momo505/Bachelorthesis/README.md

# Bachelorthesis
Repo für Bachelorarbeit
