momo505/Bachelorthesis/Kettenroboter/Hardware/KiCad/Bauteil-Library/Wuerth_Screw_Term3_2pin/WR-TBL_V3_pin2_691103110002.step

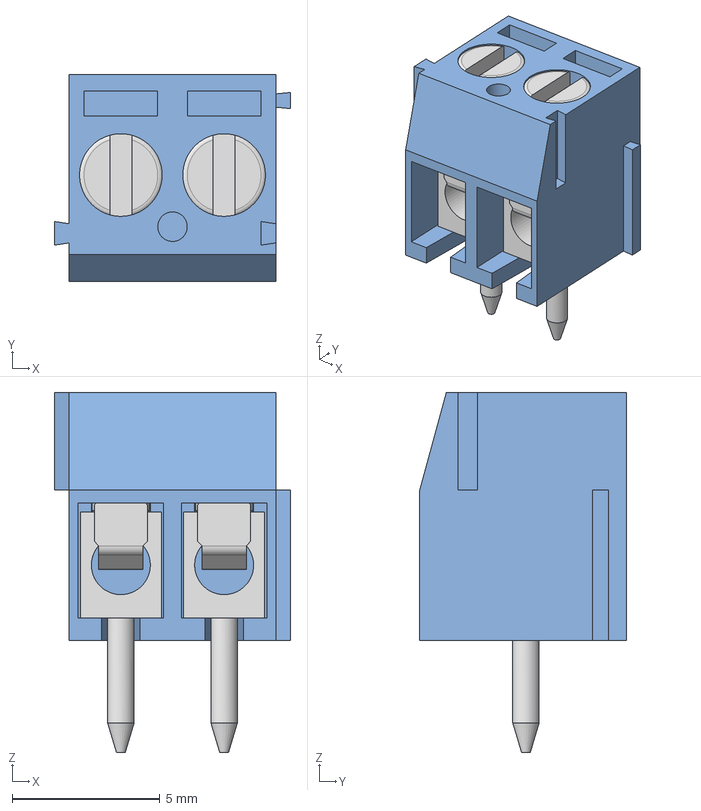
[picture p2: CAD file, 2026-04-20]
Kettenroboter/Hardware/KiCad/Bauteil-Library/Wuerth_Screw_Term3_2pin/WR-TBL_V3_pin2_691103110002.step
8.00 x 7.00 x 12.2 mm
6911031100xx_CAGE x 2
6911031100xx_PIN x 2
6911031100xx_VIS x 2
