momo505/Bachelorthesis/Kettenroboter/Software/Pico2W_TRS_Testup/deprPico2W_TRS_Testup2.txt

#include <Wire.h>
#include <FreeRTOS.h>
//#include "MySoftwareWire.h"
bool core1_separate_stack = true;
// enable FreeRTOS SMP with Tools: Operating System: FreeRTOS SMP
// compile with acli compile -j 0 -v -e -b rp2040:rp2040:rpipico2w
// (in windows compile pio asm with pioasm.exe pio_code.pio pio_code.pio.h
// find port: sudo dmesg | egrep -i --color 'ttyACM'
// arduino-cli upload I2Csketch.ino -p /dev/ttyACM0 -b rp2040:rp2040:rpipico2w
// serial: sudo screen /dev/ttyACM0 115200          (ctrl-d to detach)

// ========================= MOTOR A/B CONFIG =========================
#include "motor_config.h"

// ========================= MD03 CONFIG flipper 1 =========================
//#include "md03_config.h"

/*
volatile long encoderCount1 = 0;
volatile long encoderCount2 = 0;
volatile long encoderCount1B = 0;
volatile long encoderCount2B = 0;
*/
/*
long targetAngle = 0;
bool homed = false;
const float countsPerDegree = 24600.0 / 360.0; // 68,3333333333333
long homePosition1 = 0;
long homePosition2 = 0;
*/
#define ENCODER_COUNTS_FULL_ROT 24600.0
#define COUNTS_PER_DEGREE (ENCODER_COUNTS_FULL_ROT / 360.0)

// ========================= SOFTWARE I2C SRF02 =========================
//MySoftwareWire sw(10, 11);
byte frontSensors[] = {0x78, 0x76, 0x7E};

// ========================= FLIPPER CONTROL =========================
//#include "flipper_control.h"

// ========================= I2C HELPERS =========================
//#include "i2c_helpers.h"

// ========================= SRF02 READ =========================
//#include "srf02.h"

// ========================= MCP2515-CAN =========================

#include <Adafruit_MCP2515.h>
#include "can_db.h"
#ifdef ARDUINO_ADAFRUIT_FEATHER_RP2040
   #define ADA_CS_PIN    7
#elif defined(ARDUINO_ADAFRUIT_FEATHER_RP2040_CAN)
   #define ADA_CS_PIN    PIN_CAN_CS
#elif defined(ARDUINO_RASPBERRY_PI_PICO) || defined(ARDUINO_RASPBERRY_PI_PICO_W) // PiCowbell CAN Bus
   #define ADA_CS_PIN    20
#else
    // Anything else, defaults!
   #define ADA_CS_PIN    5
#endif
// Set CAN bus baud rate
#define CAN_BAUDRATE (250000)
Adafruit_MCP2515 mcp(ADA_CS_PIN);
//*/

//*
// ========================= Postbox / Pico-SDK Mutex =========================
#include <FreeRTOS.h>
#include "semphr.h"
#include "icc.h"
#define POSTBOXSIZE 32

SemaphoreHandle_t  pb_mutex; // = xSemaphoreCreateMutex();
volatile bool newcontent = false;
volatile uint32_t postbox[POSTBOXSIZE] = {0};
volatile long ct_pb = 0;
volatile byte motor_pb[2][7] = {0};
volatile byte flipper_pb[2][7] = {0};
volatile uint32_t flags = 0;

SemaphoreHandle_t serialmutex; 

//*

// ========================= SETUP =========================
bool success;
byte error = 10;
unsigned long c0_lastExecutedMillis, c1_lastExecutedMillis = 0;
unsigned long c0_currentMillis, c1_currentMillis = 10; //millis();
uint8_t swcase = 0;
byte motor_add[] = {MOTOR_A_ADDR, MOTOR_B_ADDR};
byte regs[] = {DIR_REG, STATUS_REG, SPEED_REG, ACCEL_REG, TEMP_REG, CURR_REG, VERSION_REG};
byte motor = 0;
bool can_available = false;
bool printvalues = false;

unsigned long c0_cycletime, c1_cycletime, ct_buf = 0;

byte motor_c0_readvalues[4][7] = {0};
byte motor_c1_readvalues[4][7] = {0};

// SINGLECORE-MODE (runs both loops sequentially on core0)
const bool singlecore = true;

bool test;

void setup() {

    // Serial Setup
    Serial.begin(1000000);
    while(!Serial){delay(10);}
    Serial.println("Serial Ready ----------------------   ");

    //Mutex für postbox
    pb_mutex = createMutex();
    serialmutex = createMutex();
    //mutexTake(serialmutex);
    if((pb_mutex != NULL) && (serialmutex != NULL)){
        Serial.println("Mutex created postbox up and working ");
    }else{
        Serial.println("!Error: Could not create Mutex!");
    }
    if(mutexTake(pb_mutex)){
        delay(1);
        mutexGive(pb_mutex);
    }
    Serial.println("Setup on core0 finished");
    Serial.print(" MCU running at "); Serial.print(rp2040.f_cpu()/1000); Serial.println(" kHz");

    //Serial.println(" Running MCP2515 Sender test!");

    ///*
    //CAN.setSPIFrequency(frequency);
    if (!mcp.begin(CAN_BAUDRATE)) {
        Serial.println("Error initializing MCP2515.");
        can_available = false;
    }else{
        Serial.println("MCP2515 chip found");
        can_available = true;
    }
    //*/

    //
    //if(Wire1.setSCL() && Wire1.setSDA()){
        //Serial.println("starting Sensor-I2C");
    //}else{
        //Serial.println("Could not start Sensor-I2C");
    //}
    //mutexGive(serialmutex);
   // rp2040.restartCore1();
   if(singlecore==true){
        //rp2040.idleOtherCore();
        setupCore1(); 
        Serial.println("Program running on Core0 only (Singlecore)");
    }else{
        Serial.println("Program running on both Cores (Dualcore)");
    }
}

void setupCore1(){ // Core1: Motor control, QEI & Control loops
    pinMode(LED_BUILTIN, OUTPUT);
    digitalWrite(LED_BUILTIN, HIGH);

    //Serial.println("Serial switched to Core1");
    
    /*
    success = Wire.setSCL(1) && Wire.setSDA(0);
    */
    Wire.setSCL(1); Wire.setSDA(0);
    //*/

    //Serial.println("starting Motor-I2C");
    Wire.begin();
    //Serial.println("Motor-I2C should be up, Resuming Serial to Core0");
    //mutexGive(serialmutex);
    digitalWrite(LED_BUILTIN, LOW);
}

void setup1(){ if(singlecore==false){setupCore1();}}

// ========================= LOOP =========================
void loop() {

    c0_currentMillis = millis();
    if (c0_currentMillis - c0_lastExecutedMillis >= 471) 
    {
    c0_lastExecutedMillis = c0_currentMillis; // save the last executed time

    test=!test;
    //if(test=true){rp2040.idleOtherCore();}else{rp2040.resumeOtherCore();}

    Serial.println("    Ping from Core0");
    if(mutexTake(pb_mutex)){
        Serial.println(" Mutex availabe for Core0, copy OP started");
        if(newcontent == true){
            newcontent = false;
            Serial.println(" new content available:");

            // Kopiert die 28 Bytes aus der Postbox zurück in das lokale 2D-Array
            memcpy(motor_c0_readvalues, (void*)&postbox[0], sizeof(motor_c0_readvalues));
            
            printvalues = true;
        }else{
            Serial.println("! no new content available :(");
            printvalues = false;
        }
        ct_buf = ct_pb;

        mutexGive(pb_mutex);

        if(printvalues==true){

        for(int i=0; i<2; i++){
            Serial.print("   -> Data from Motor "); Serial.print(i); Serial.println(": "); Serial.print(" { ");
            for(int ii=0; ii<7; ii++){
                Serial.print(" [ Value "); Serial.print(ii); Serial.print(": "); Serial.print(motor_c1_readvalues[i][ii]); Serial.print(" ] ");
            }
            Serial.println(" } ");
        }
        printvalues = false;
        
        }
    }else{
        Serial.println("<- Mutex taken ");
    }

    Serial.print(" core0 cycle time: "); Serial.println((int)c0_cycletime);
    Serial.print(" core1 cycle time: "); Serial.println((int)ct_pb);

    // CAN-Comms:
    Serial.println("CAN-MCP-Test:");
    mcp.beginPacket(0x12);
    mcp.write('h');
    mcp.write('e');
    mcp.write('l');
    mcp.write('l');
    mcp.write('o');
    mcp.endPacket();

    // Serial Input
    
    for(int i=Serial.available(); i>=0; i--){
        Serial.read();
    }

    Serial.println("loop0 finished");
    //rp2040.resumeOtherCore();
    c0_cycletime = millis() - c0_currentMillis; 
    }
    if(singlecore==true){loopCore1();}
}

void loopCore1(){ // Core1: Motor control, QEI & Control loops

    c1_currentMillis = millis();
    //if ((c1_currentMillis - c1_lastExecutedMillis >= 100)  || (singlecore==true) /* */) {
    c1_lastExecutedMillis = c1_currentMillis; // save the last executed time

    digitalWrite(LED_BUILTIN, !digitalRead(LED_BUILTIN));
    for(int j=0; j<2; j++){

    //Wire.begin();
    for(int jj=0; jj<7; jj++){
    Wire.beginTransmission(motor_add[j]);
    Wire.write(regs[jj]);
    //error = 
    Wire.endTransmission(true);
    /*Serial.print(error);
    switch (error) 
    {case 1: Serial.println("Success"); break; case 2: Serial.println("Data too long"); break; case 3: Serial.println("NACK on transmit of address"); break; case 4: Serial.println("NACK on transmit of data"); break; case 5: Serial.println("Timeout"); break;}
    */

    Wire.requestFrom(motor_add[j], 1);

    if(Wire.available()){
        motor_c1_readvalues[j][jj] = Wire.read();
    }else{
    }
    //Wire.endTransmission(true);
    }
    //Wire.end();
    }
    
    // Postbox-Exchange:
    // Mutex sperren (z. B. xSemaphoreTake / mutex_enter_blocking)
    if(mutexTake(pb_mutex)){
    // Kopiert die 28 Bytes ab dem gewünschten START_INDEX in die Postbox
    memcpy((void*)&postbox[0], motor_c1_readvalues, sizeof(motor_c1_readvalues));

    ct_pb = c1_cycletime;

    newcontent = true;

    // Mutex entsperren (z. B. xSemaphoreGive / mutex_exit)
    mutexGive(pb_mutex);
    }
    
    c1_cycletime = millis() - c1_currentMillis;
    /*
    }
    //*/
}

void loop1(){ if(singlecore==false){loopCore1();}}
