momo505/Bachelorthesis/Kettenroboter/Hardware/KiCad/Basis/Basis.kicad_pcb

## KiCad design Kettenroboter/Hardware/KiCad/Basis/Basis.kicad_pcb (2026-04-20)

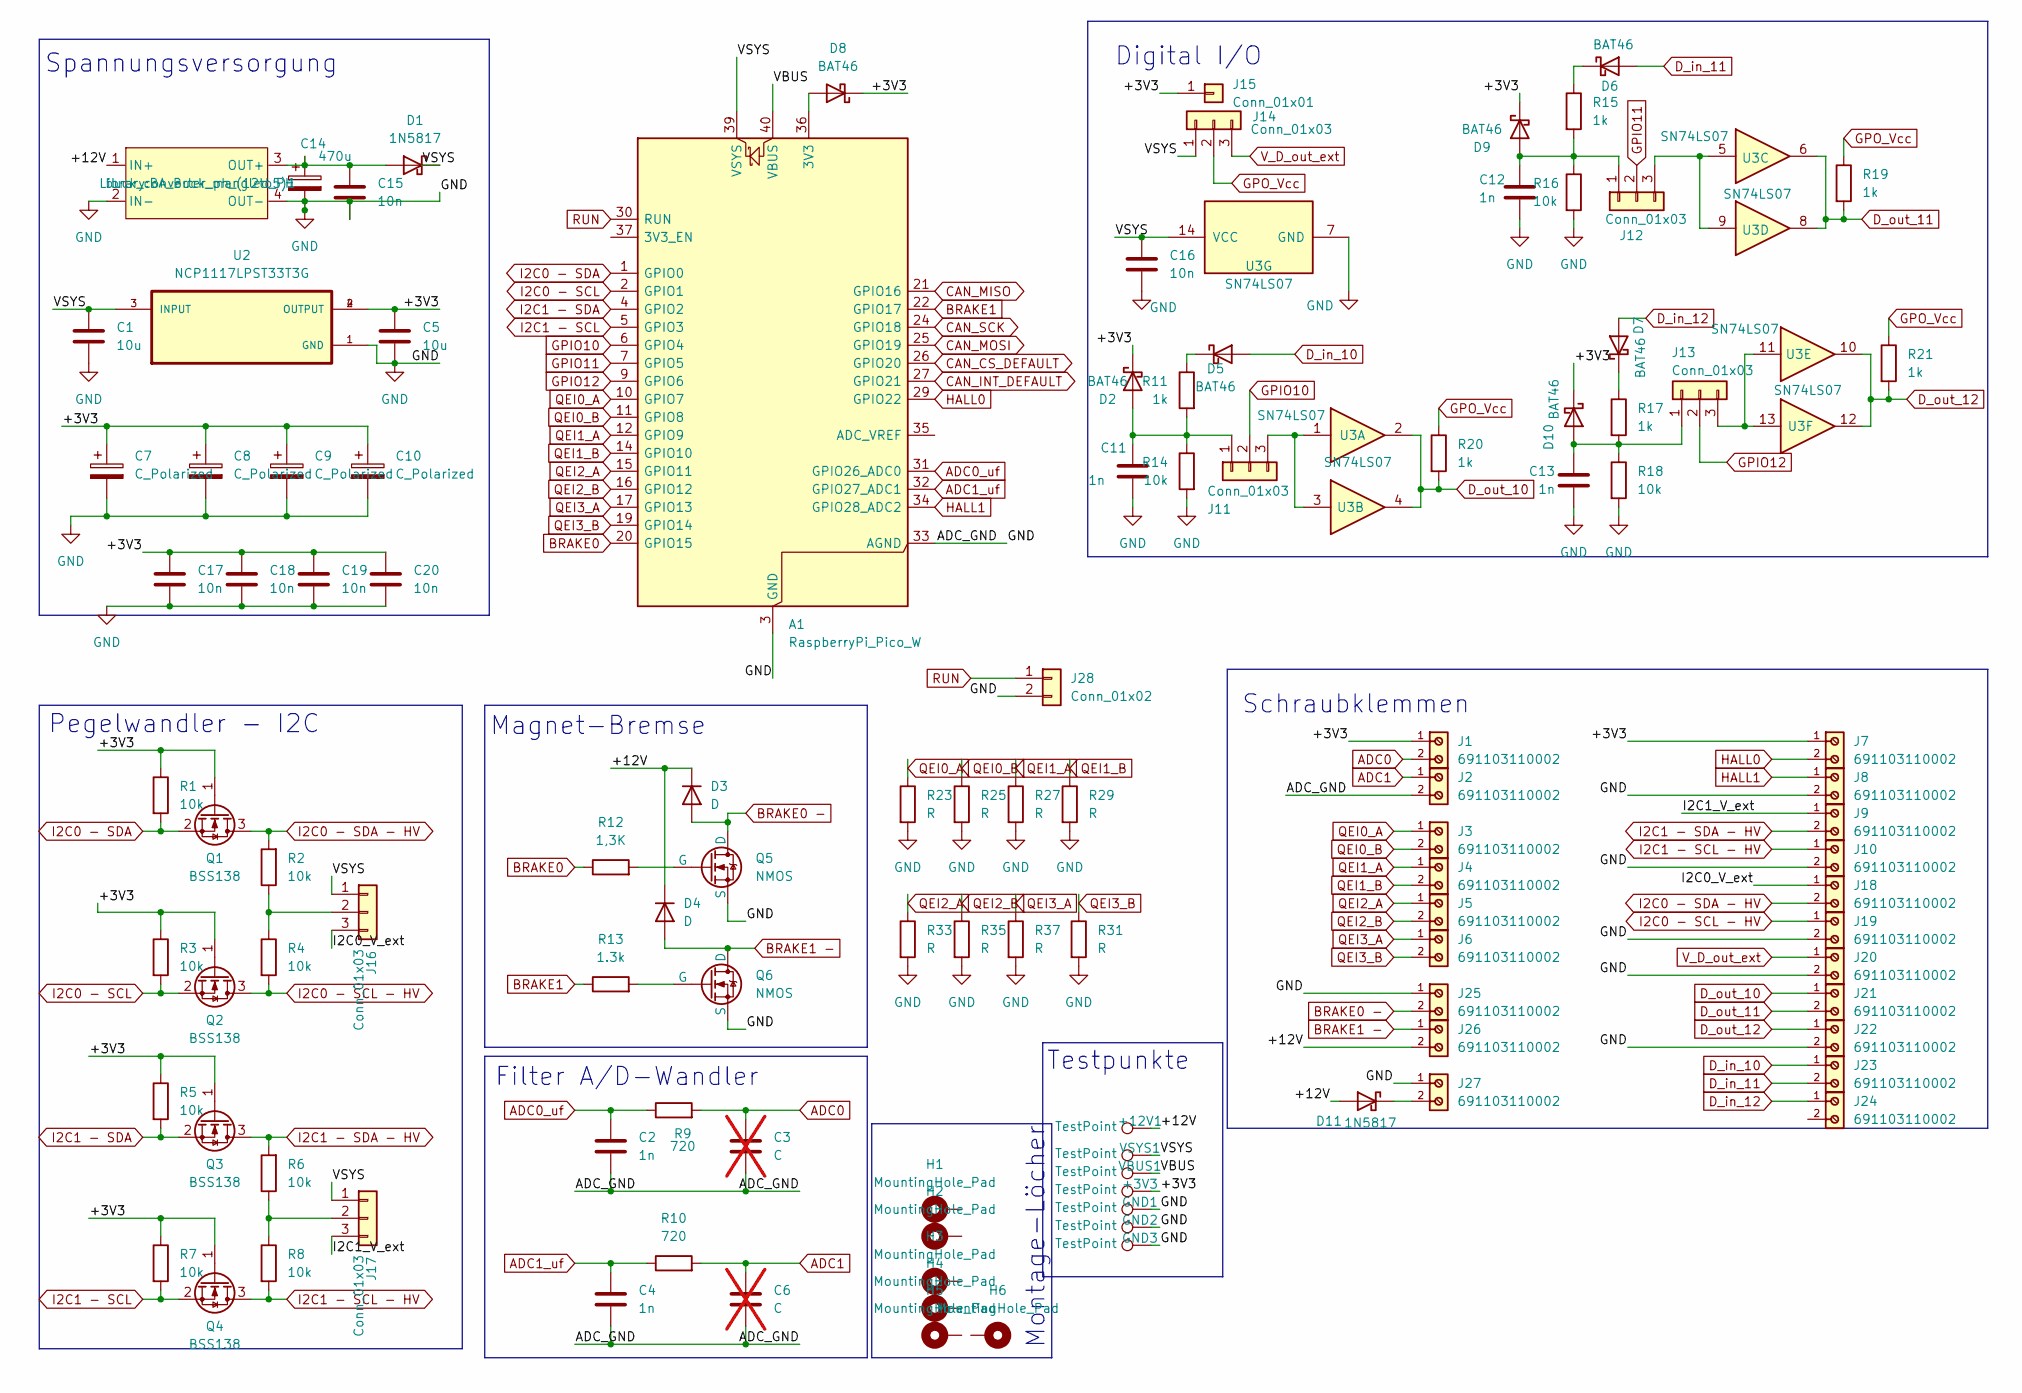
[picture p3: schematic Basis.kicad_sch]

Parts:
+3V3, +12V1: TestPoint; TestPoint_Pad_D2.5mm
A1: RaspberryPi_Pico_W; RaspberryPi_Pico_Common_THT
C1, C5: 10u; C_1206_3216Metric_Pad1.33x1.80mm_HandSolder
C2, C4, C11, C12, C13: 1n; C_1206_3216Metric_Pad1.33x1.80mm_HandSolder
C3, C6: C; C_1206_3216Metric_Pad1.33x1.80mm_HandSolder; not fitted
C7, C8, C9, C10: C_Polarized; CP_Radial_D5.0mm_P2.50mm
C14: 470u; CP_Radial_D5.0mm_P2.50mm
C15, C16, C17, C18, C19, C20: 10n; C_1206_3216Metric_Pad1.33x1.80mm_HandSolder
D1, D11: 1N5817; D_DO-41_SOD81_P10.16mm_Horizontal
D2, D5, D6, D7, D8, D9, D10: BAT46; D_DO-35_SOD27_P7.62mm_Horizontal
D3, D4: D; D_5KPW_P7.62mm_Vertical_AnodeUp
GND1, GND2, GND3: TestPoint; TestPoint_Pad_D2.5mm
H1, H2: MountingHole_Pad; MountingHole_3.2mm_M3_Pad_Via
H3, H4, H5, H6: MountingHole_Pad; MountingHole_4.3mm_M4_Pad_Via
J1, J2, J3, J4, J5, J6, J7, J8, J9, J10, J18, J19, J20, J21, J22, J23, J24, J25, J26, J27: 691103110002; WR-TBL_V3_2pin_691103110002
J11, J12, J13, J14, J16, J17: Conn_01x03; PinHeader_1x03_P2.54mm_Vertical
J15: Conn_01x01; PinHeader_1x01_P2.54mm_Vertical
J28: Conn_01x02; PinHeader_1x02_P2.54mm_Vertical
Q1, Q2, Q3, Q4: BSS138; SOT-23
Q5, Q6: NMOS; SOT-23_AO3400
R1, R2, R3, R4, R5, R6, R7, R8, R14, R16, R18: 10k; R_1206_3216Metric_Pad1.30x1.75mm_HandSolder
R9, R10: 720; R_1206_3216Metric_Pad1.30x1.75mm_HandSolder
R11, R15, R17, R19, R20, R21: 1k; R_1206_3216Metric_Pad1.30x1.75mm_HandSolder
R12: 1,3K; R_1206_3216Metric_Pad1.30x1.75mm_HandSolder
R13: 1.3k; R_1206_3216Metric_Pad1.30x1.75mm_HandSolder
R23, R25, R27, R29, R31, R33, R35, R37: R; R_1206_3216Metric_Pad1.30x1.75mm_HandSolder
U2: NCP1117LPST33T3G; NCP1117_SOT230P700X175-4N
U3: SN74LS07; SOIC127P600X175-14N
VBUS1: TestPoint; TestPoint_Pad_D2.5mm
VSYS1: TestPoint; TestPoint_Pad_D2.5mm
buck_converter_ph_(12to5)1: BA_Buck_mangled_PH

Connections:
/+3V3: +3V3.1, C5.1, C7.1, C8.1, C9.1, C10.1, C17.1, C18.1, C19.1, C20.1, D2.1 (K), D8.1 (K), D9.1 (K), D10.1 (K), J1.1, J7.1, J15.1, Q1.1 (G), Q2.1 (G), Q3.1 (G), Q4.1 (G), R1.1, R3.1, R5.1, R7.1, U2.2 (OUTPUT), U2.4 (OUTPUT)
/+12V: +12V1.1, D3.1 (K), D4.1 (K), D11.2 (A), J26.2, buck_converter_ph_(12to5)1.1 (IN+)
/I2C0_V_ext: J16.3, J18.1
/I2C1_V_ext: J9.1, J17.3
/VBUS: A1.40 (VBUS), VBUS1.1
/VSYS: A1.39 (VSYS), C1.1, C16.1, D1.1 (K), J14.1, J16.1, J17.1, U2.3 (INPUT), U3.14 (VCC), VSYS1.1
ADC0: C3.1, J1.2, R9.2
ADC0_uf: A1.31 (GPIO26_ADC0), C2.1, R9.1
ADC1: C6.1, J2.1, R10.2
ADC1_uf: A1.32 (GPIO27_ADC1), C4.1, R10.1
BRAKE0: A1.20 (GPIO15), R12.1
BRAKE0 -: D3.2 (A), J25.2, Q5.1 (D)
BRAKE1: A1.22 (GPIO17), R13.1
BRAKE1 -: D4.2 (A), J26.1, Q6.1 (D)
CAN_CS_DEFAULT: A1.26 (GPIO20)
CAN_INT_DEFAULT: A1.27 (GPIO21)
CAN_MISO: A1.21 (GPIO16)
CAN_MOSI: A1.25 (GPIO19)
CAN_SCK: A1.24 (GPIO18)
D_in_10: D5.2 (A), J23.1
D_in_11: D6.2 (A), J23.2
D_in_12: D7.2 (A), J24.1
D_out_10: J21.1, R20.2, U3.2, U3.4
D_out_11: J21.2, R19.2, U3.6, U3.8
D_out_12: J22.1, R21.2, U3.10, U3.12
GND: A1.3 (GND), A1.8 (GND), A1.13 (GND), A1.18 (GND), A1.23 (GND), A1.28 (GND), A1.33 (AGND), A1.38 (GND), C1.2, C2.2, C3.2, C4.2, C5.2, C6.2, C7.2, C8.2, C9.2, C10.2, C11.2, C12.2, C13.2, C14.2, C15.2, C16.2, C17.2, C18.2, C19.2, C20.2, GND1.1, GND2.1, GND3.1, J2.2, J8.2, J10.2, J19.2, J20.2, J22.2, J25.1, J27.1, J28.2, Q5.3 (S), Q6.3 (S), R14.2, R16.2, R18.2, R23.2, R25.2, R27.2, R29.2, R31.2, R33.2, R35.2, R37.2, U2.1 (GND), U3.7 (GND), buck_converter_ph_(12to5)1.2 (IN-), buck_converter_ph_(12to5)1.4 (OUT-)
GPIO10: A1.6 (GPIO4), J11.2
GPIO11: A1.7 (GPIO5), J12.2
GPIO12: A1.9 (GPIO6), J13.2
GPO_Vcc: J14.2, R19.1, R20.1, R21.1
HALL0: A1.29 (GPIO22), J7.2
HALL1: A1.34 (GPIO28_ADC2), J8.1
I2C0 - SCL: A1.2 (GPIO1), Q2.2 (S), R3.2
I2C0 - SCL - HV: J19.1, Q2.3 (D), R4.2
I2C0 - SDA: A1.1 (GPIO0), Q1.2 (S), R1.2
I2C0 - SDA - HV: J18.2, Q1.3 (D), R2.2
I2C1 - SCL: A1.5 (GPIO3), Q4.2 (S), R7.2
I2C1 - SCL - HV: J10.1, Q4.3 (D), R8.2
I2C1 - SDA: A1.4 (GPIO2), Q3.2 (S), R5.2
I2C1 - SDA - HV: J9.2, Q3.3 (D), R6.2
unnamed: A1.36 (3V3), D8.2 (A)
unnamed: C14.1, C15.1, D1.2 (A), buck_converter_ph_(12to5)1.3 (OUT+)
unnamed: C11.1, D2.2 (A), J11.1, R11.2, R14.1
unnamed: D5.1 (K), R11.1
unnamed: D6.1 (K), R15.1
unnamed: D7.1 (K), R17.1
unnamed: C12.1, D9.2 (A), J12.1, R15.2, R16.1
unnamed: C13.1, D10.2 (A), J13.1, R17.2, R18.1
unnamed: D11.1 (K), J27.2
unnamed: J11.3, U3.1, U3.3
unnamed: J12.3, U3.5, U3.9
unnamed: J13.3, U3.11, U3.13
unnamed: J16.2, R2.1, R4.1
unnamed: J17.2, R6.1, R8.1
unnamed: Q5.2 (G), R12.2
unnamed: Q6.2 (G), R13.2
QEI0_A: A1.10 (GPIO7), J3.1, R23.1
QEI0_B: A1.11 (GPIO8), J3.2, R25.1
QEI1_A: A1.12 (GPIO9), J4.1, R27.1
QEI1_B: A1.14 (GPIO10), J4.2, R29.1
QEI2_A: A1.15 (GPIO11), J5.1, R33.1
QEI2_B: A1.16 (GPIO12), J5.2, R35.1
QEI3_A: A1.17 (GPIO13), J6.1, R37.1
QEI3_B: A1.19 (GPIO14), J6.2, R31.1
RUN: A1.30 (RUN), J28.1
V_D_out_ext: J14.3, J20.1

Notes on the sheet:
Spannungsversorgung
Magnet-Bremse
Pegelwandler - I2C
Testpunkte
Digital I/O
Schraubklemmen
Montage-Löcher
Filter A/D-Wandler

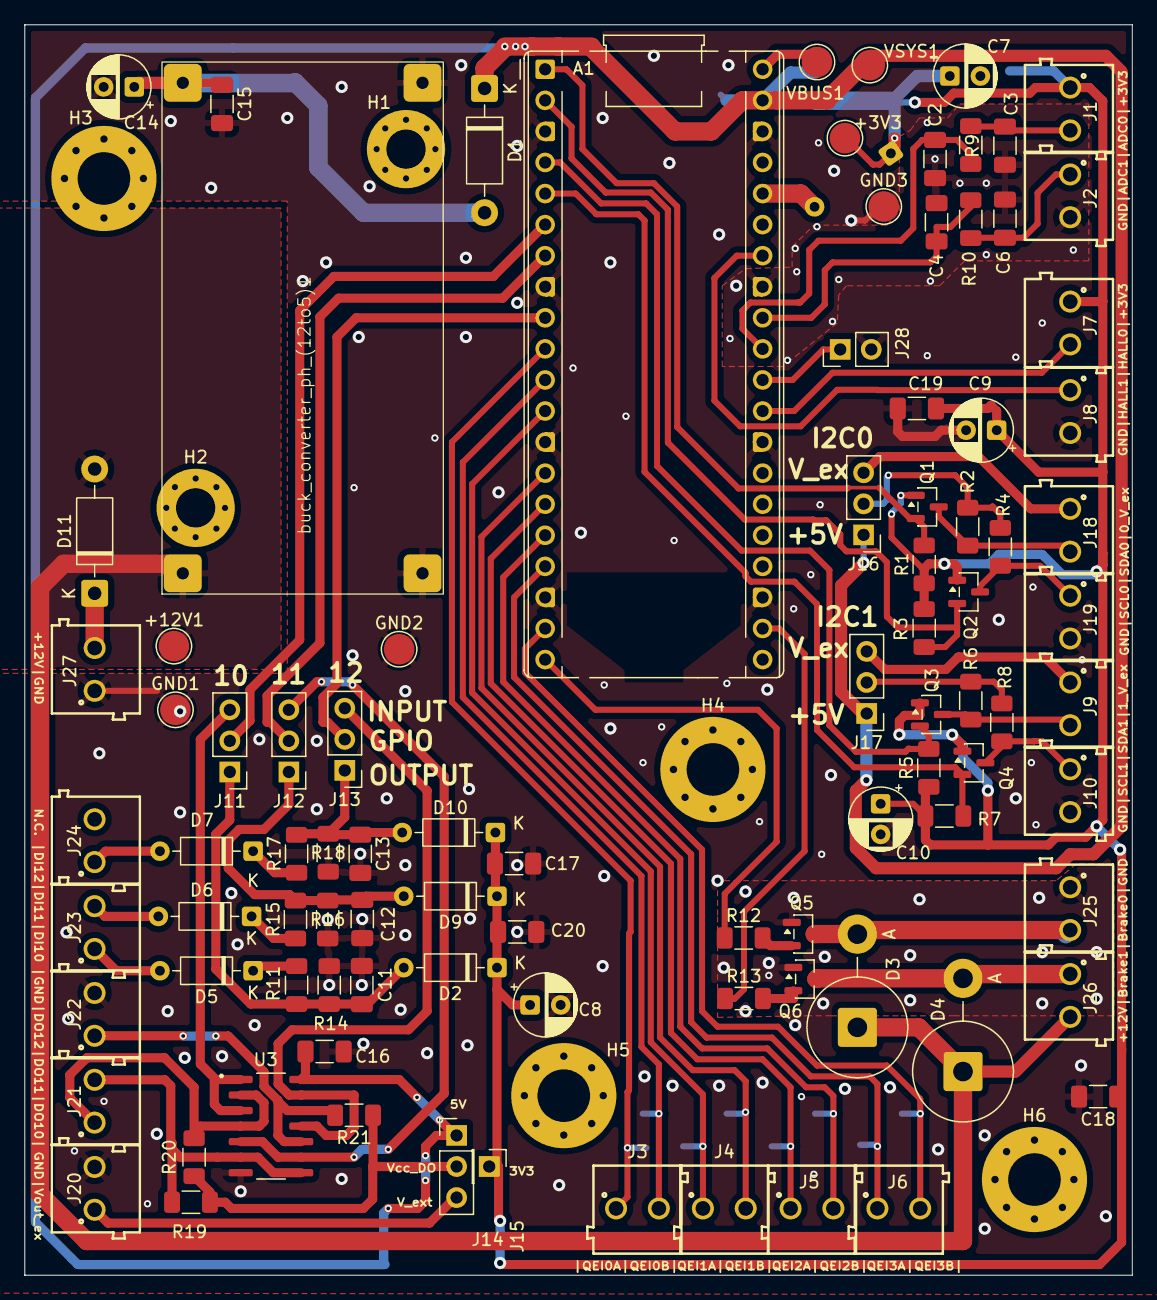
[picture p4: board Basis.kicad_pcb from above]

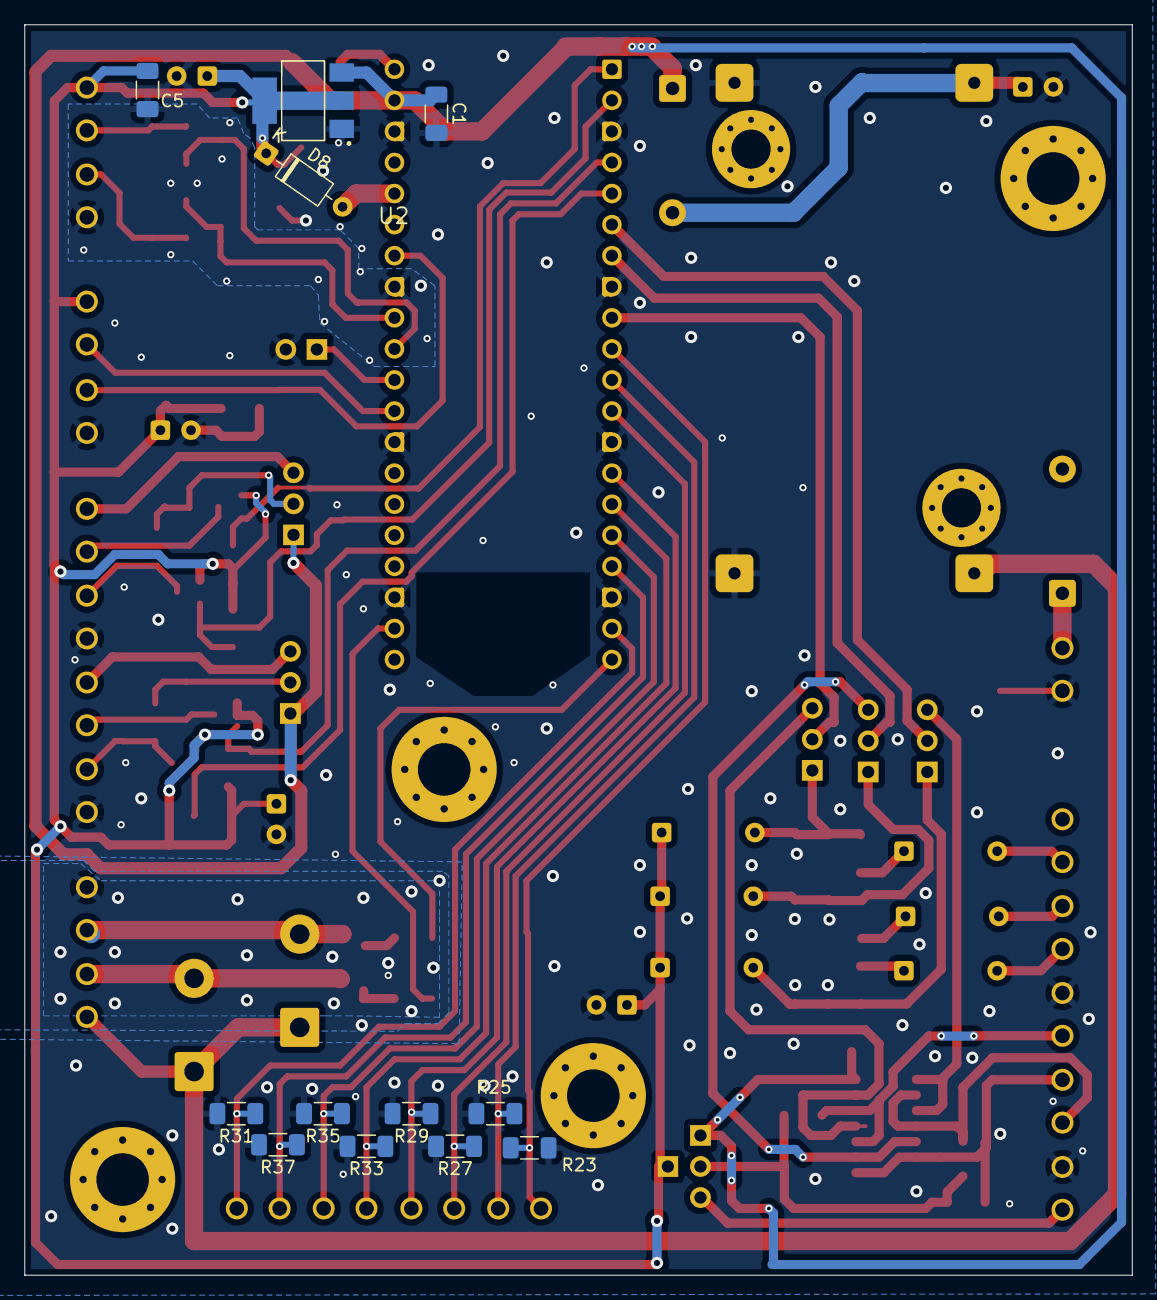
[picture p5: board Basis.kicad_pcb from below]

Board: 2 copper layers, 90.6 x 102.2 mm, 111 parts (12 on the bottom side), 61 nets.
