momo505/Bachelorthesis/Kettenroboter/Software/alter_Code/Gradual_Tracked_robot_structured_Windows/Pico2W_TRS/board_pins.h

#ifndef pico2_trs_board_pinout
#define pico2_trs_board_pinout

#define I2C0_SDA 0
#define I2C0_SCL 1

#define I2C1_SDA 2
#define I2C1_SDA 3

#define DIO_1 4
#define DIO_2 5
#define DIO_3 5

#define QEI0_A 7
#define QEI0_B 8
#define QEI1_A 9
#define QEI1_B 10
#define QEI2_A 11
#define QEI2_B 12
#define QEI3_A 13
#define QEI3_B 14

#define BRAKE_A 15
#define BRAKE_B 17

#define HALL_A 29
#define HALL_B 28

#endif
