momo505/Bachelorthesis/Kettenroboter/Software/alter_Code/Gradual_Tracked_robot_structured_Windows/Pico2W_TRS/md03_config.h

#ifndef MD03_CONFIG
#define MD03_CONFIG

// ========================= MD03 CONFIG flipper 1 =========================
#define MD03_ADDR 0x59
#define encoder_ChA 19
//#define encoder_ChB 17
//#define hallSensorPin 52
//#define brakePin 7
//#define CMD_REG 0x00
//#define CMD_FORWARD 0x01
//#define CMD_REVERSE 0x02

// ========================= MD03 CONFIG flipper 2 =========================
#define MD03_ADDR2 0x58
//#define encoder_ChA2 18
//#define encoder_ChB2 16
//#define hallSensorPin2 50
//#define brakePin2 6

#endif
