momo505/Bachelorthesis/(commit log)

2025-12-03 alles was bleibt vom alten Repo übernommen
    [Basis.kicad_pcb, Basis.kicad_sch, Input_Supply_3V3.kicad_sch]
2026-02-07 Zum Commit vorgemerkte Änderungen: neue Datei: KiCad/Basis/Basis-backups/Basis-2026-01-28_145330.zip neue Datei: KiCad/Basis/Basis-backups/Basis-2026-01-28_151514.zip neue Datei: KiCad/Basis/Basis-ba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
    [Basis.kicad_pcb, Basis.kicad_sch, Input_Supply_3V3.kicad_sch, Raspberrypi pico2 W.step]
2026-02-17 Auf Branch sw_job_division Zum Commit vorgemerkte Änderungen: geändert: Kettenroboter/Software/alter_Code/Gradual_Tracked_robot_structured_Windows/Pico2W_TRS/Pico2W_TRS.ino geändert: Kettenroboter/So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
    [Pico2W_TRS.ino, flipper_control.cpp, icc.cpp, icc.h]
2026-02-26 Nets korrigiert, etc
    [Basis.kicad_sch]
2026-02-26 Neues Pico W Symol & Footprint
    [Basis.kicad_pcb, Basis.kicad_sch]
2026-03-11 pcb layout fnished
    [Basis.kicad_pcb, Basis.kicad_sch, WR-TBL_V3_pin2_691103110002.step]
2026-03-17 Fast finale Version
    Nach Crash gefixt
    [Basis.kicad_pcb, Basis.kicad_sch, Basis_original.kicad_pcb]
2026-03-19 final final final
    [Basis.kicad_pcb, Basis.kicad_sch]
2026-04-02 neue Datei: Kettenroboter/Software/alter_Code/Gradual_Tracked_robot_structured_Windows/Pico2W_TRS/board_pins.h
2026-04-20 All Parts placed (BOM)
    [Basis.kicad_pcb, Basis.kicad_sch]
2026-04-20 Auf Branch sw_pio_dev Zum Commit vorgemerkte Änderungen: neue Datei: Kettenroboter/Software/Pico2W_TRS_Testup/LA-Bus-reads/MotorAB-I2C-reads/i2c.pvs neue Datei: Kettenroboter/Software/Pico2W_TRS_Test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
